alexjegers/RX7-Coolant-Temp-Controller-/Electrical/PCB Layout.JPG

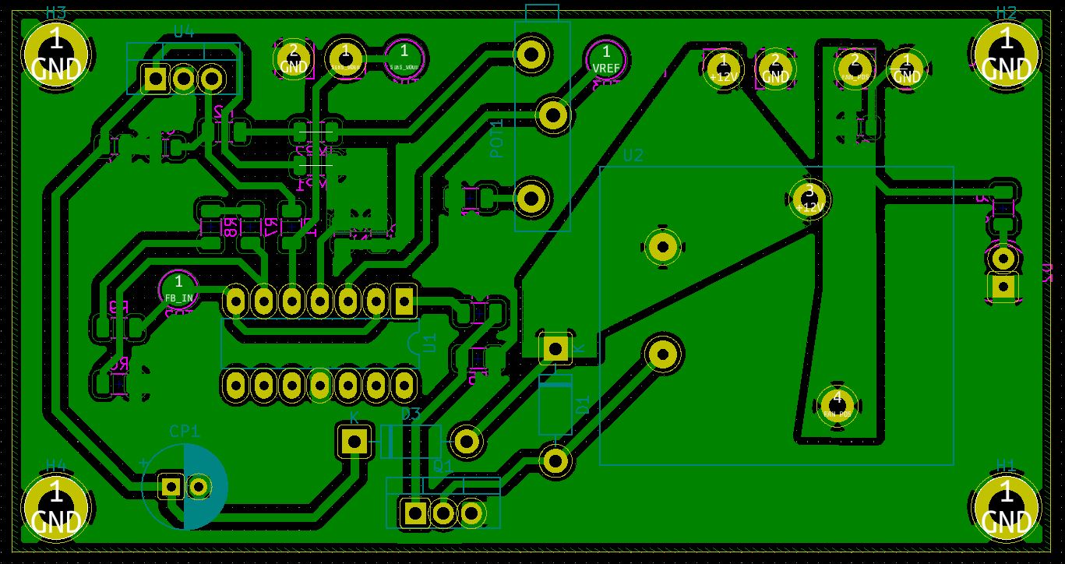
Electrical/PCB Layout.JPG
