alexjegers/RX7-Coolant-Temp-Controller-/Forum Posts/Comparator Circuit.PNG

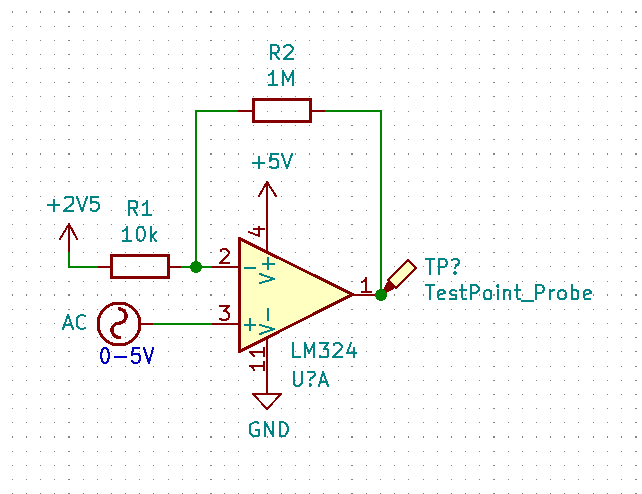
Forum Posts/Comparator Circuit.PNG
