alexjegers/RX7-Coolant-Temp-Controller-/Forum Posts/Reverse Polarity Circuit1.PNG

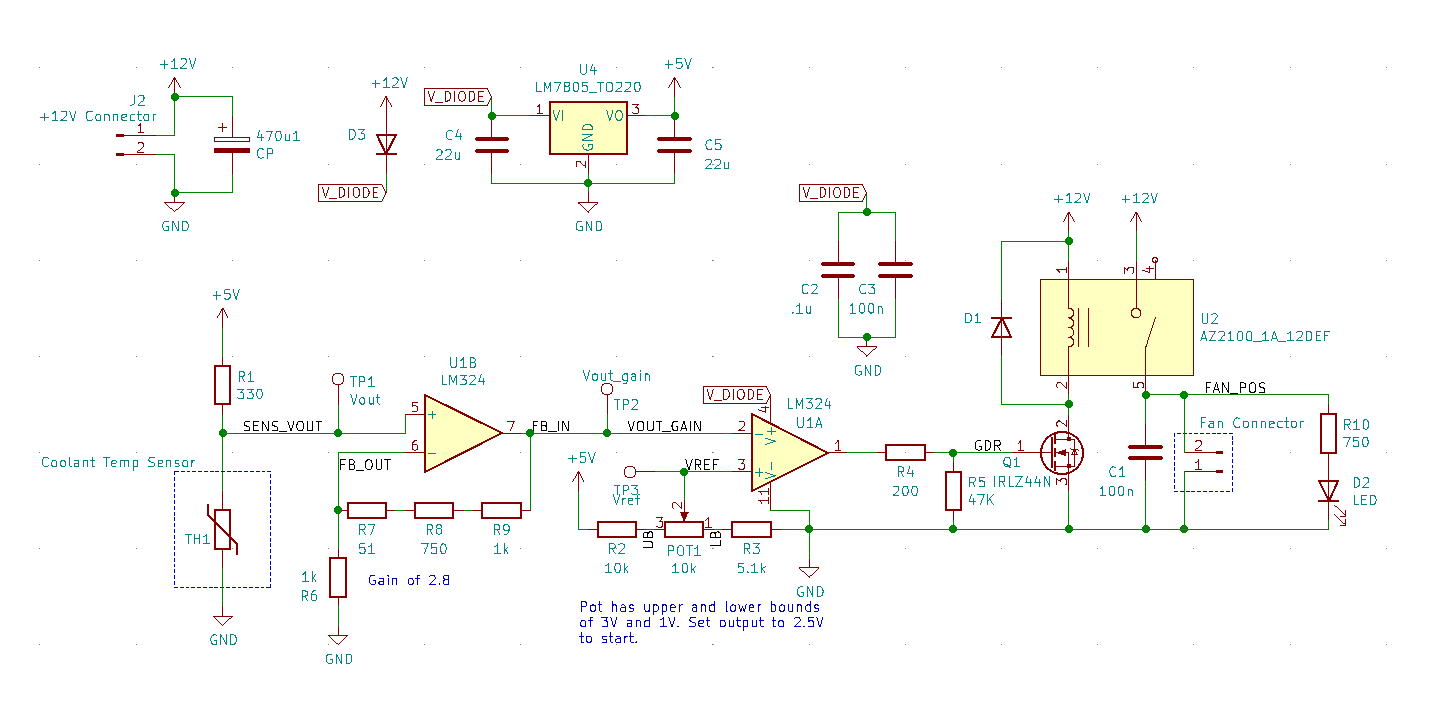
Forum Posts/Reverse Polarity Circuit1.PNG
