alexjegers/RX7-Coolant-Temp-Controller-/Forum Posts/Reverse Polarity Circuit2.PNG

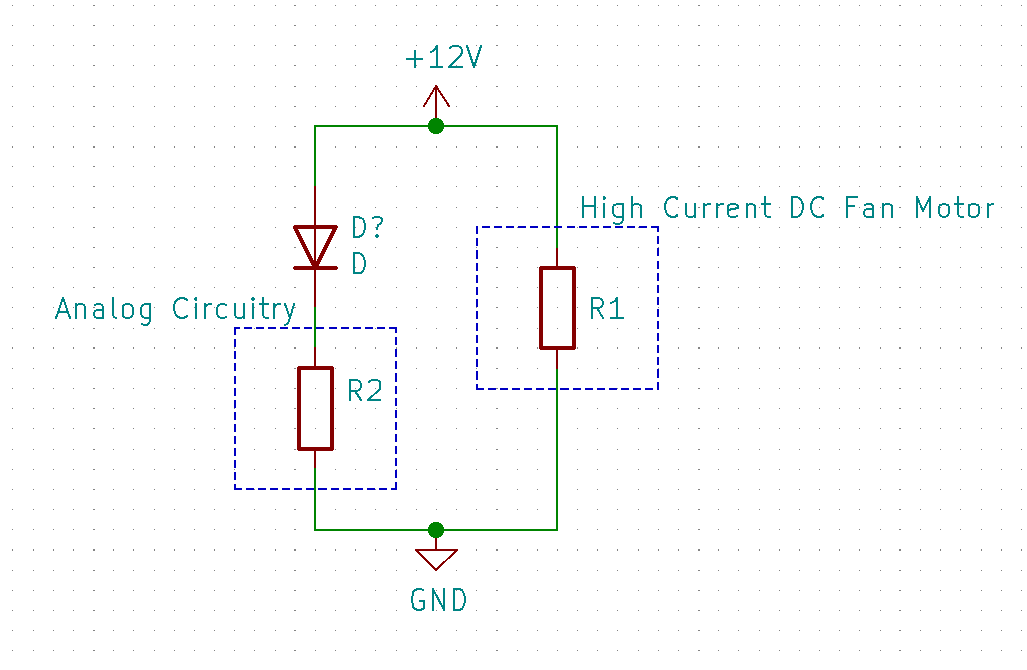
Forum Posts/Reverse Polarity Circuit2.PNG
