alexjegers/RX7-Coolant-Temp-Controller-/Forum Posts/Scope Capture.png

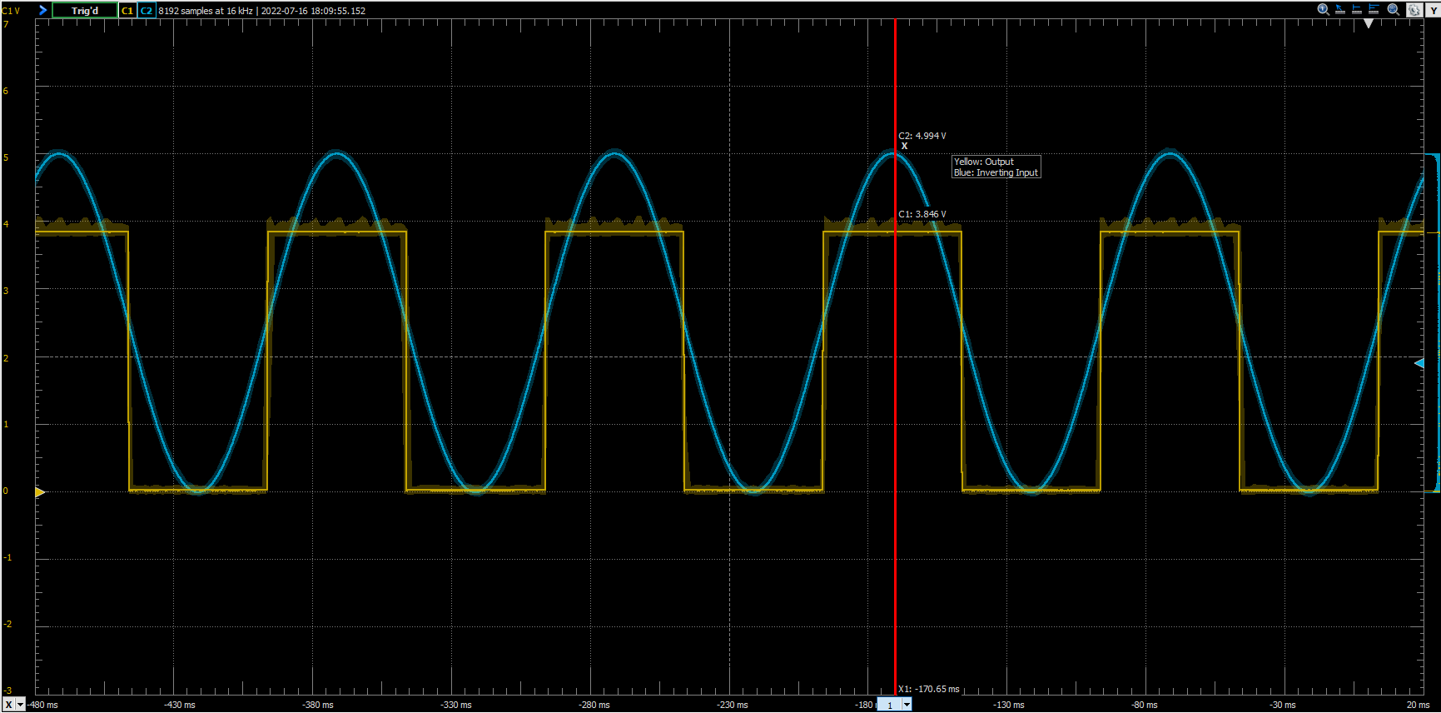
Forum Posts/Scope Capture.png
