alexjegers/RX7-Coolant-Temp-Controller-/CAD/RX7_COOLANT_TEMP_CONTROLLER_PCB_001.SLDASM

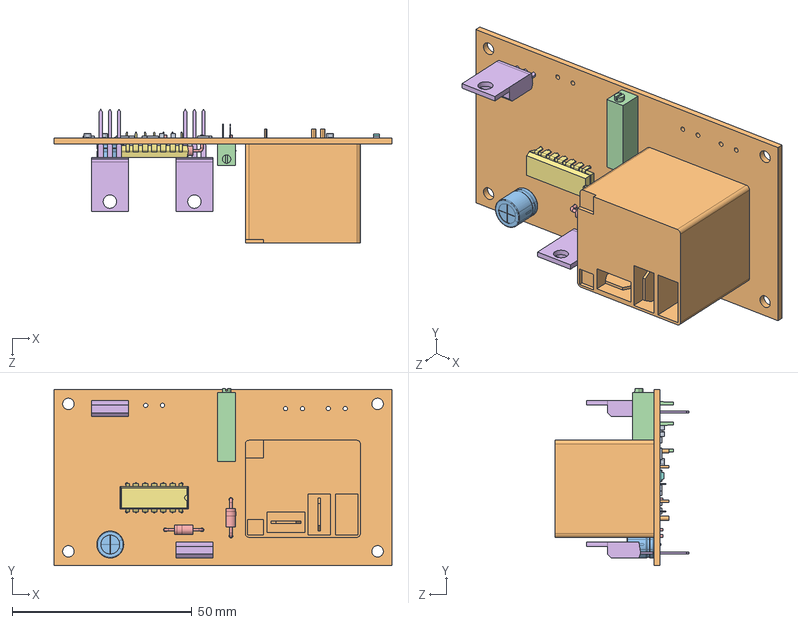
[picture p6: CAD file, 2022-11-08]
CAD/RX7_COOLANT_TEMP_CONTROLLER_PCB_001.SLDASM
94.0 x 49.4 x 37.2 mm
SOLID.step x 12
COMPOUND.step
SOLID-0.step
COMPOUND-1.step
SOLID-2.step x 2
SOLID-3.step x 2
SOLID-4.step
SOLID-5.step
SOLID-6.step x 5
COMPOUND-7.step
