alexjegers/RX7-Coolant-Temp-Controller-/CAD/FINAL_ASSEM_001.SLDASM

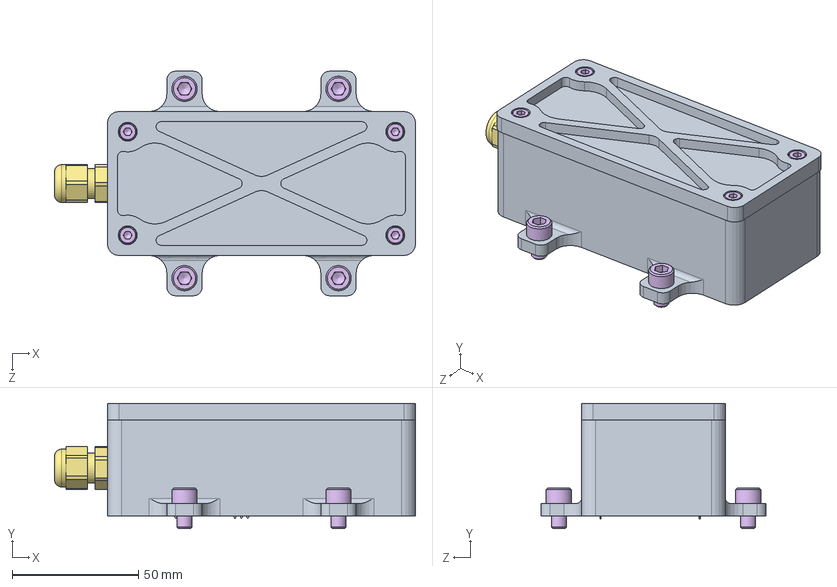
[picture p7: CAD file, 2022-11-08]
CAD/FINAL_ASSEM_001.SLDASM
143.0 x 49.6 x 89.0 mm
PCB_ENCLOSURE_001
SOLID.step x 12
COMPOUND.step
SOLID-0.step
COMPOUND-1.step
SOLID-2.step x 2
SOLID-3.step x 2
SOLID-4.step
SOLID-5.step
SOLID-6.step x 5
COMPOUND-7.step
M3_THREADED_INSERT x 4
M4_THREADED_INSERT x 4
socket head cap screw_am x 12
WIRE_STRAIN_RELIEF_SMALL_001
WIRE_STRAIN_RELIEF_SMALL_002
PCB_ENCLOSURE_LID_001
