alexjegers/RX7-Coolant-Temp-Controller-/CAD/WIRE_STRAIN_RELIEF_SMALL_001.SLDPRT

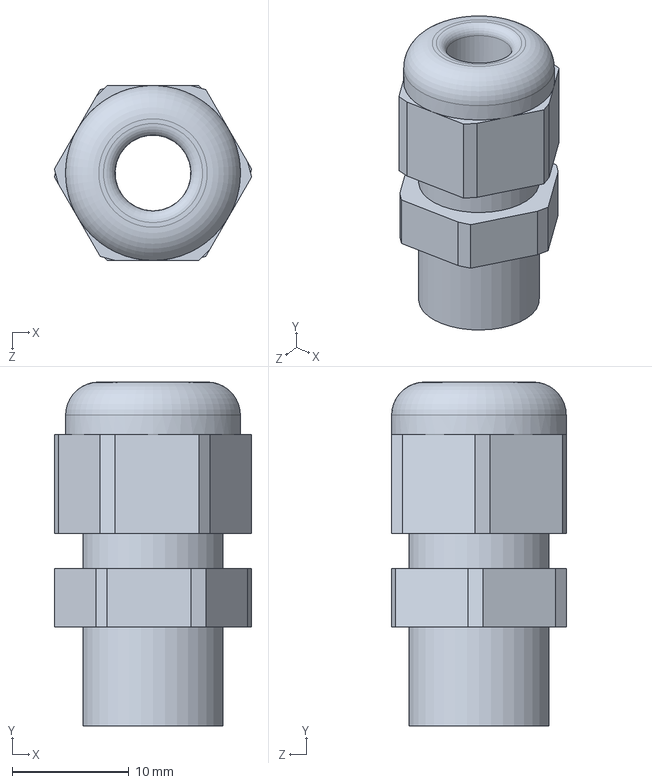
[picture p8: CAD file, 2022-11-08]
CAD/WIRE_STRAIN_RELIEF_SMALL_001.SLDPRT
16.9 x 29.5 x 15.0 mm
