alexjegers/RX7-Coolant-Temp-Controller-/CAD/PCB_ENCLOSURE_001.SLDPRT

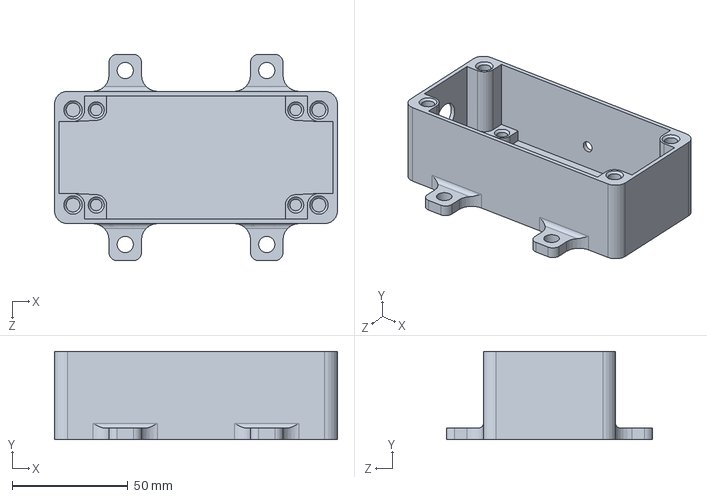
[picture p9: CAD file, 2022-11-08]
CAD/PCB_ENCLOSURE_001.SLDPRT
122.0 x 38.0 x 89.0 mm
