alexjegers/RX7-Coolant-Temp-Controller-/CAD/PCB_ENCLOSURE_LID_001.SLDPRT

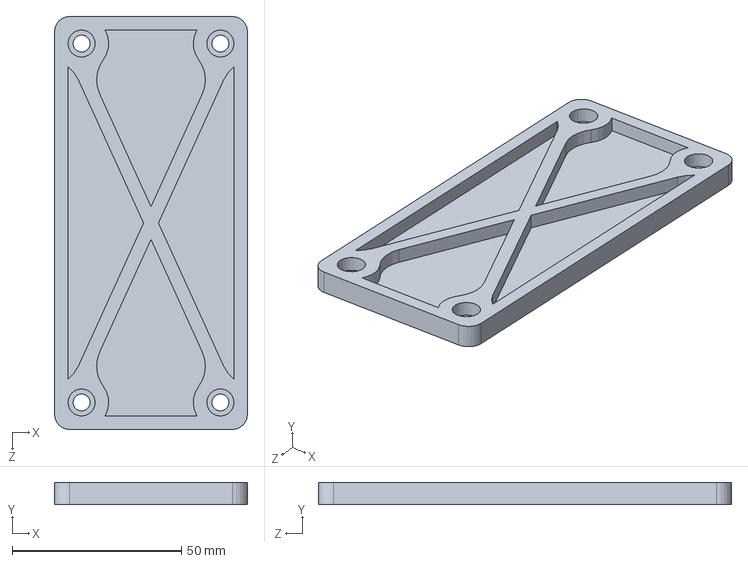
[picture p10: CAD file, 2022-11-08]
CAD/PCB_ENCLOSURE_LID_001.SLDPRT
57.0 x 6.60 x 122.0 mm
