alexjegers/RX7-Coolant-Temp-Controller-/CAD/M3_THREADED_INSERT.SLDPRT

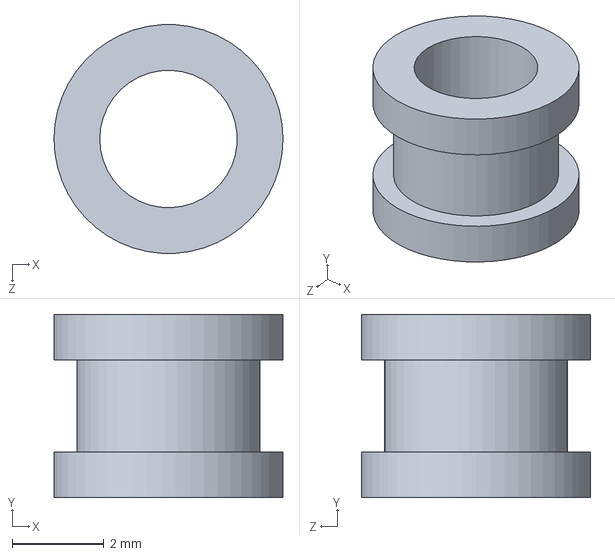
[picture p11: CAD file, 2022-11-08]
CAD/M3_THREADED_INSERT.SLDPRT
5.00 x 4.00 x 4.99 mm
