alexjegers/RX7-Coolant-Temp-Controller-/CAD/WIRE_STRAIN_RELIEF_SMALL_002.SLDPRT

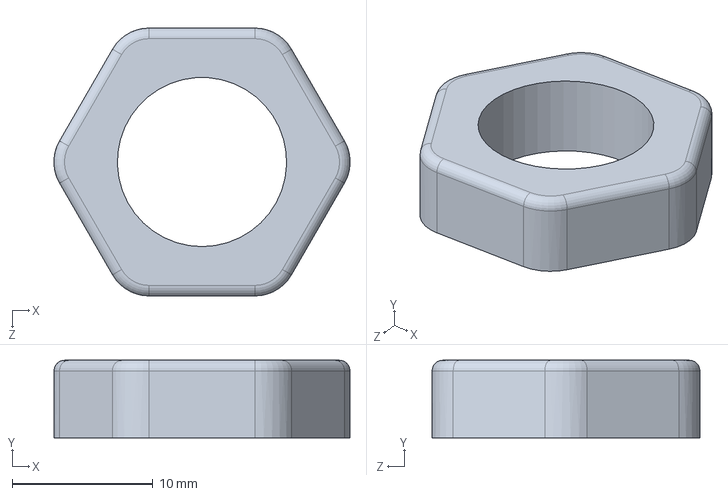
[picture p12: CAD file, 2022-11-08]
CAD/WIRE_STRAIN_RELIEF_SMALL_002.SLDPRT
21.0 x 5.50 x 19.0 mm
