alexjegers/RX7-Coolant-Temp-Controller-/CAD/POTENTIOMETER_3D_001.STEP

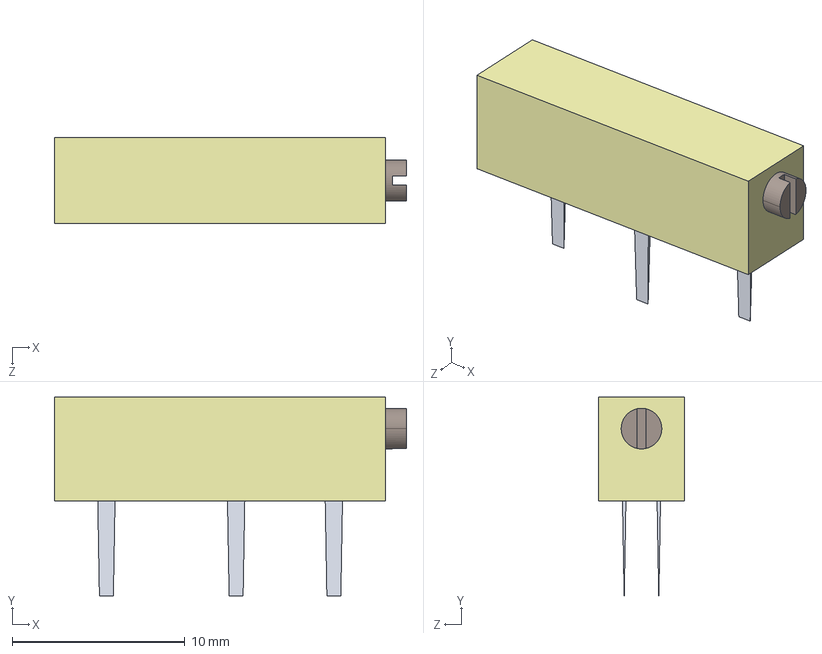
[picture p13: CAD file, 2022-11-08]
CAD/POTENTIOMETER_3D_001.STEP
20.3 x 11.5 x 5.00 mm
