alexjegers/RX7-Coolant-Temp-Controller-/CAD/RELAY_3D_001.STEP

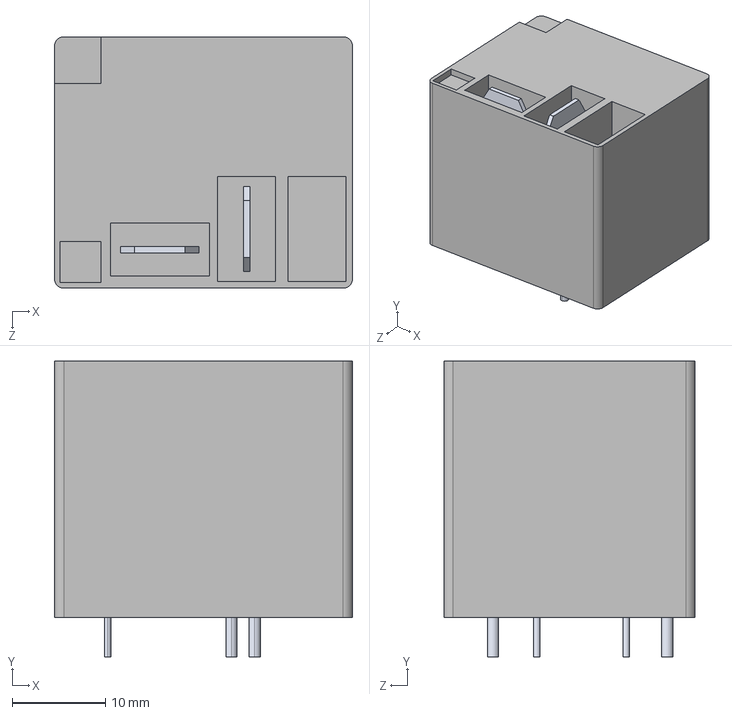
[picture p14: CAD file, 2022-11-08]
CAD/RELAY_3D_001.STEP
32.0 x 31.8 x 27.0 mm
