alexjegers/RX7-Coolant-Temp-Controller-/CAD/M4_THREADED_INSERT.SLDPRT

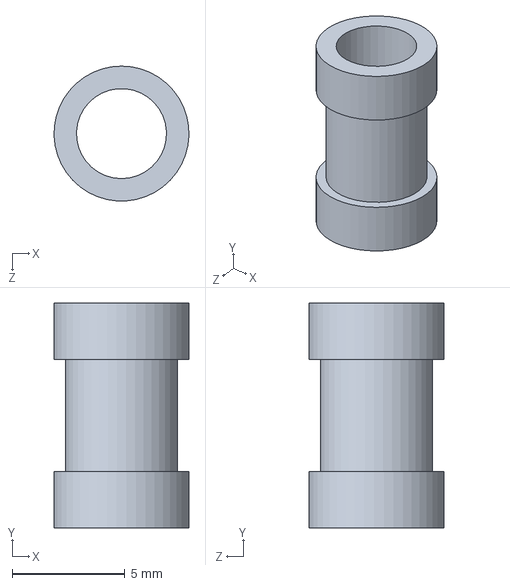
[picture p15: CAD file, 2022-11-08]
CAD/M4_THREADED_INSERT.SLDPRT
6.00 x 10.0 x 5.99 mm
