alexjegers/RX7-Coolant-Temp-Controller-/(list of files, cad)

Other CAD files:
CAD/RX7_COOLANT_TEMP_CONTROLLER.step
CAD/STL_PCB_ENCLOSURE_001.STL
CAD/PCB_ENCLOSURE_LID_001.STL
CAD/POTENTIOMETER_3D_001.SLDPRT
CAD/RELAY_3D_001.SLDPRT
