alexjegers/RX7-Coolant-Temp-Controller-/Electrical/RX7_COOLANT_TEMP_CONTROLLER.pdf

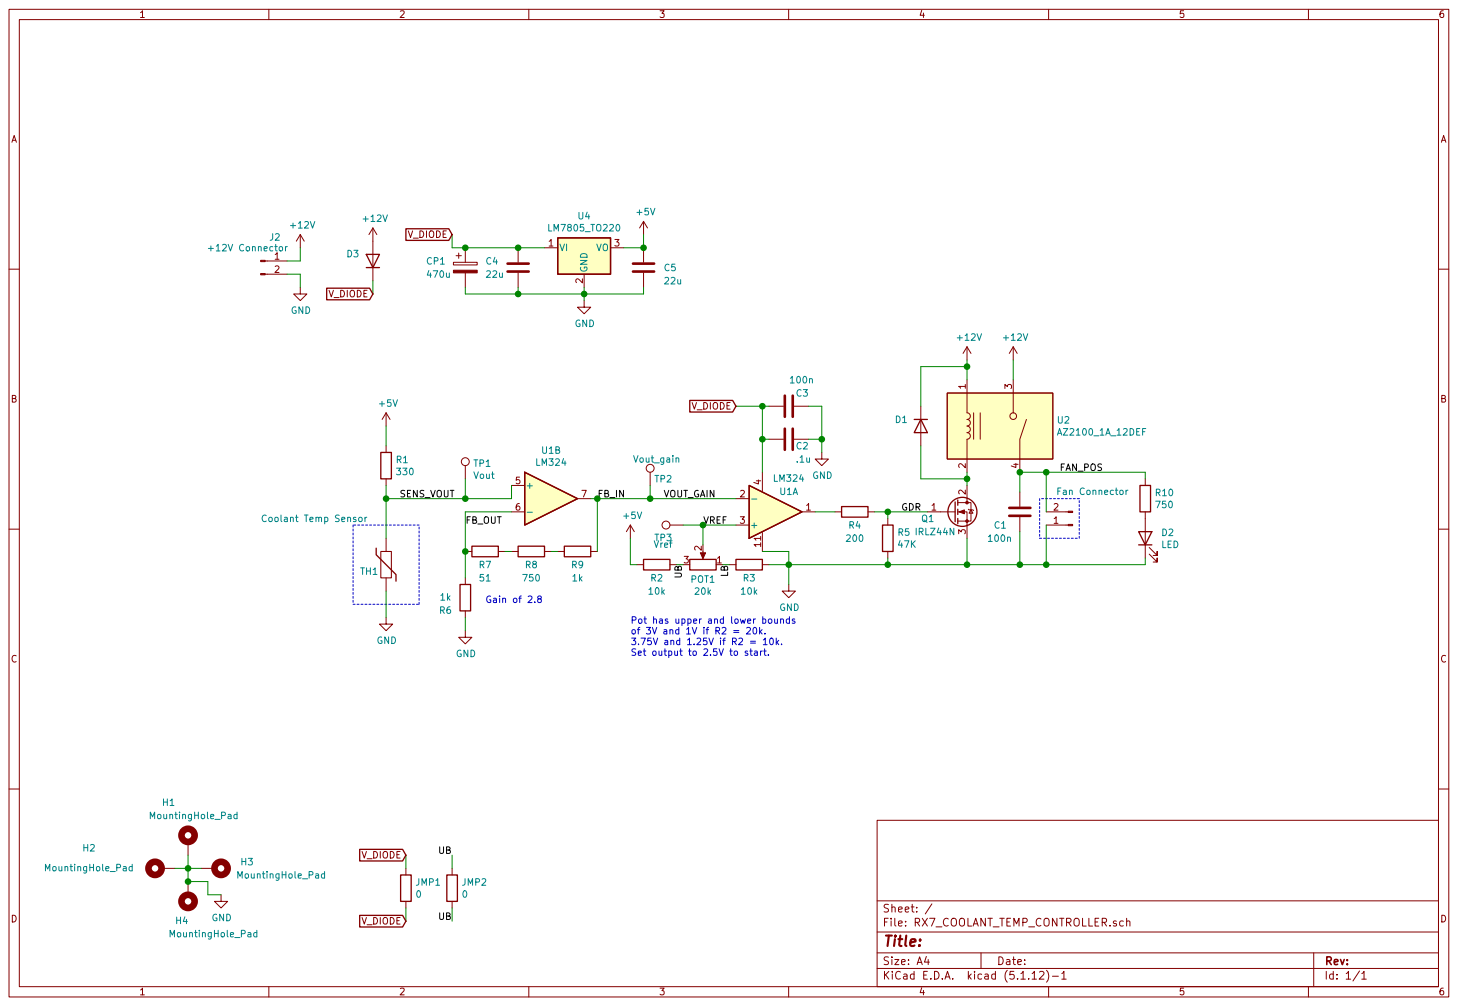
[picture p16: page 1]
