alexjegers/RX7-Coolant-Temp-Controller-/Electrical/RX7_COOLANT_TEMP_CONTROLLER.kicad_pcb

## KiCad design Electrical/RX7_COOLANT_TEMP_CONTROLLER.kicad_pcb (2022-11-08)

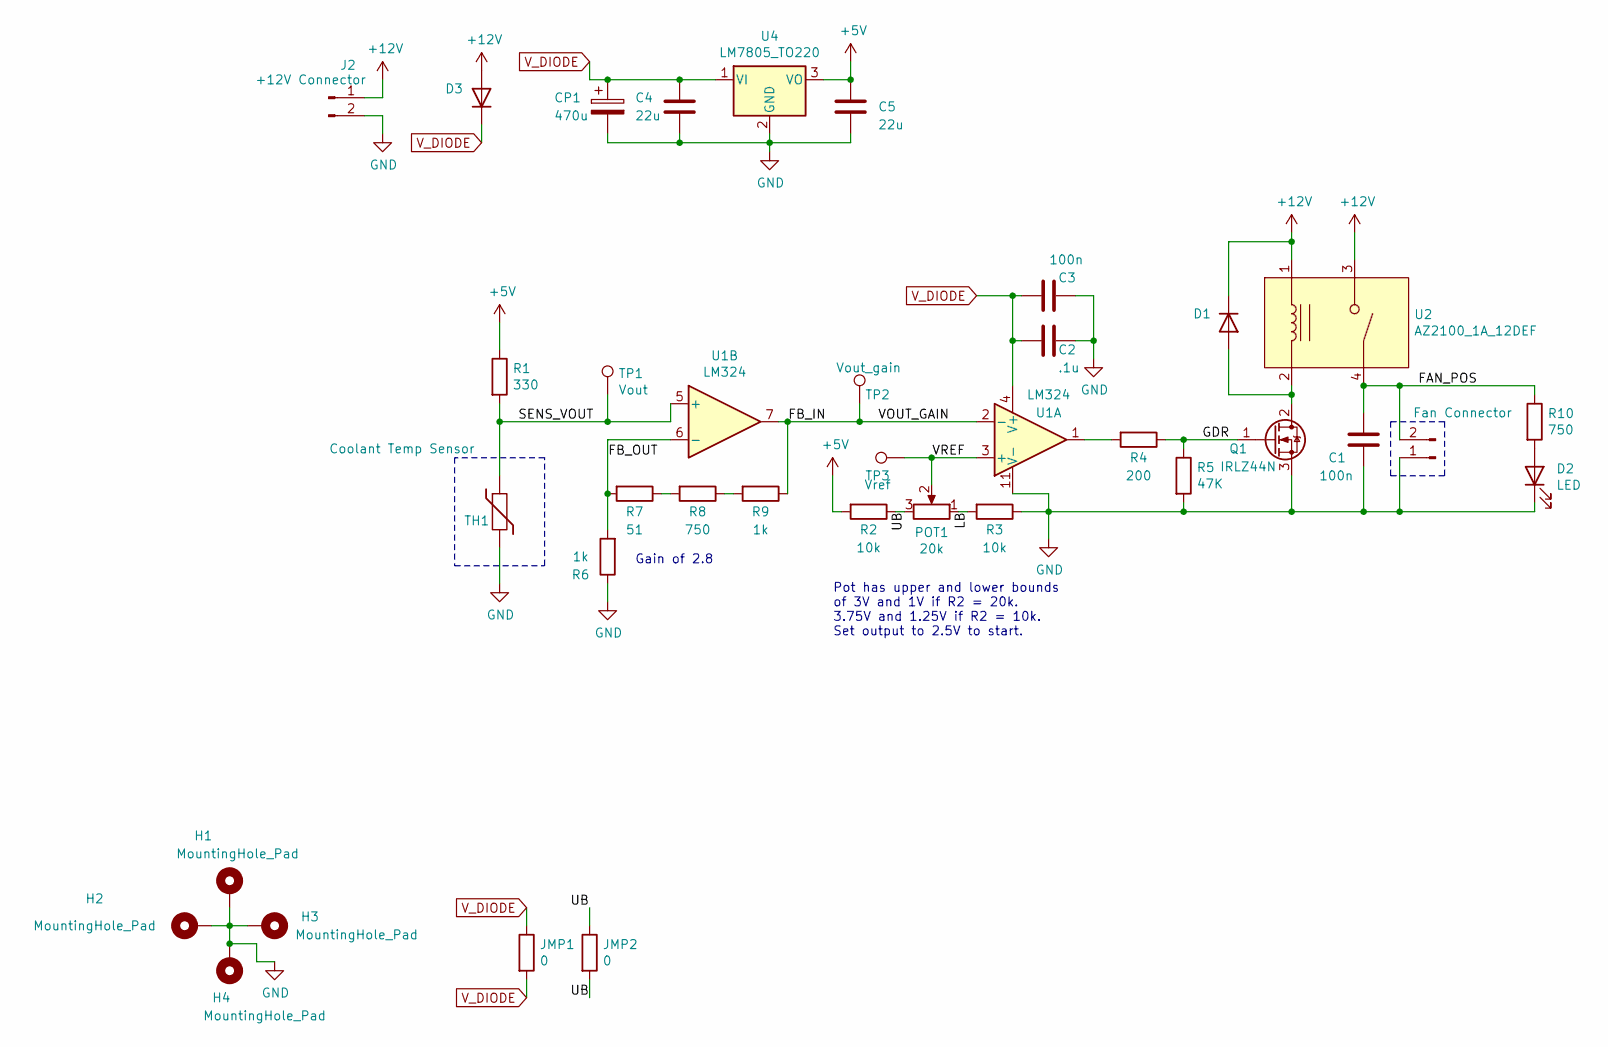
[picture p17: schematic RX7_COOLANT_TEMP_CONTROLLER.sch]

Parts:
C1, C3: 100n; C_0805_2012Metric
C2: .1u; C_0805_2012Metric
C4, C5: 22u; C_0805_2012Metric
CP1: 470u; CP_Radial_D7.5mm_P2.50mm
D1, D3: 1N1589; D_DO-41_SOD81_P10.16mm_Horizontal
D2: LED; LED_D5.0mm
H1, H2, H3, H4: MountingHole_Pad; MountingHole_3.2mm_M3_DIN965_Pad
J1: Fan Connector; RX-7_COOLANT_TEMP_2_PIN_CONN
J2: +12V Connector; RX-7_COOLANT_TEMP_2_PIN_CONN
JMP1, JMP2: 0; R_1206_3216Metric
POT1: 20k; 20K_RECT_POT
Q1: IRLZ44N; TO-220-3_Vertical
R1: 330; R_1206_3216Metric
R2, R3: 10k; R_1206_3216Metric
R4: 200; R_1206_3216Metric
R5: 47K; R_1206_3216Metric
R6, R9: 1k; R_1206_3216Metric
R7: 51; R_1206_3216Metric
R8, R10: 750; R_1206_3216Metric
TH1: Coolant Temp Sensor; RX-7_COOLANT_TEMP_2_PIN_CONN
TP1: Vout; TestPoint_Pad_D3.0mm
TP2: Vout_gain; TestPoint_Pad_D3.0mm
TP3: Vref; TestPoint_Pad_D3.0mm
U1: LM324; DIP-14_W7.62mm_LongPads
U2: AZ2100_1A_12DEF
U4: LM7805_TO220; TO-220-3_Vertical

Connections:
+5V: C5.1, R1.1, R2.2, U4.3 (VO)
+12V: D1.1 (K), D3.2 (A), J2.1, U2.1, U2.3
/FAN_POS: C1.1, J1.2, R10.1, U2.4
/FB_IN: R9.1, TP2.1, U1.2 (-), U1.7
/FB_OUT: R6.2, R7.2, U1.6 (-)
/GDR: Q1.1 (G), R4.1, R5.1
/LB: POT1.1, R3.2
/SENS_VOUT: R1.2, TH1.1, TP1.1, U1.5 (+)
/UB: JMP2.1, JMP2.2, POT1.3, R2.1
/VREF: POT1.2, TP3.1, U1.3 (+)
GND: C1.2, C2.1, C3.1, C4.2, C5.2, CP1.2, D2.1 (K), H1.1, H2.1, H3.1, H4.1, J1.1, J2.2, Q1.3 (S), R3.1, R5.2, R6.1, TH1.2, U1.11 (V-), U4.2 (GND)
unnamed: D1.2 (A), Q1.2 (D), U2.2
unnamed: D2.2 (A), R10.2
unnamed: R4.2, U1.1
unnamed: R7.1, R8.2
unnamed: R8.1, R9.2
V_DIODE: C2.2, C3.2, C4.1, CP1.1, D3.1 (K), JMP1.1, JMP1.2, U1.4 (V+), U4.1 (VI)

Notes on the sheet:
Gain of 2.8
Pot has upper and lower bounds of 3V and 1V if R2 = 20k. 3.75V and 1.25V if R2 = 10k. Set output to 2.5V to start.

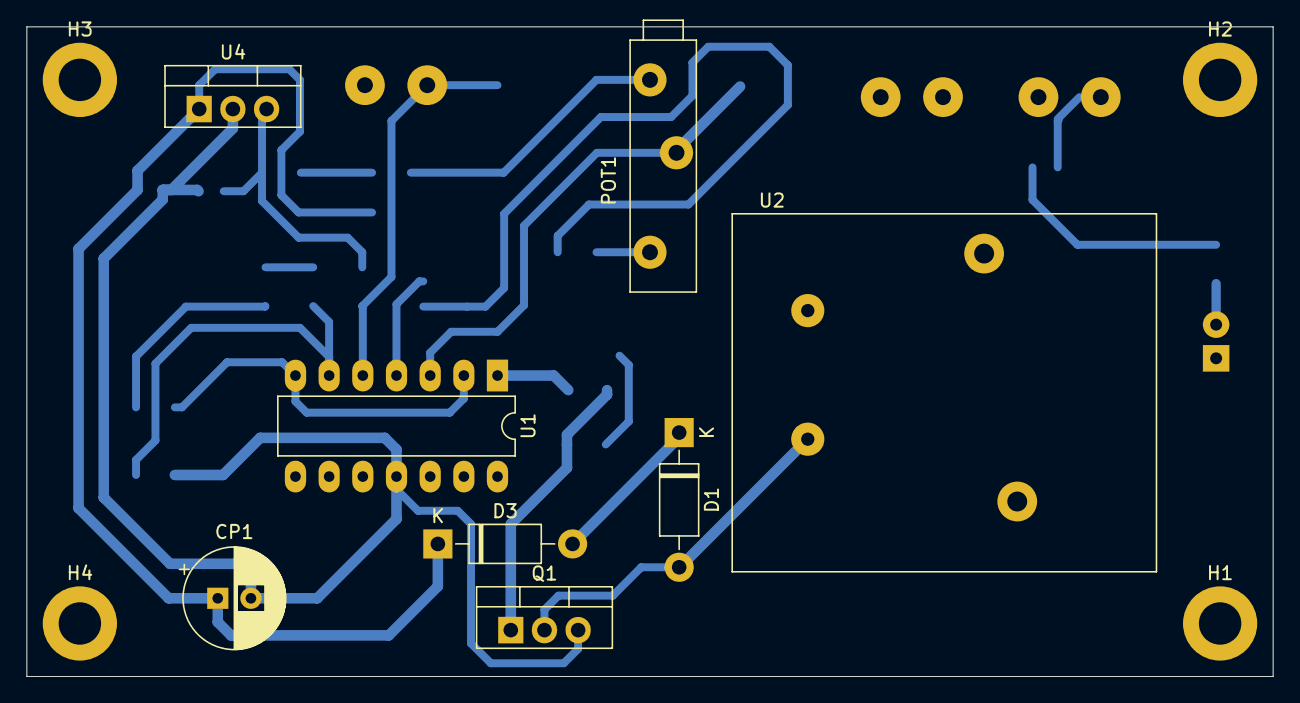
[picture p18: board RX7_COOLANT_TEMP_CONTROLLER.kicad_pcb from above]

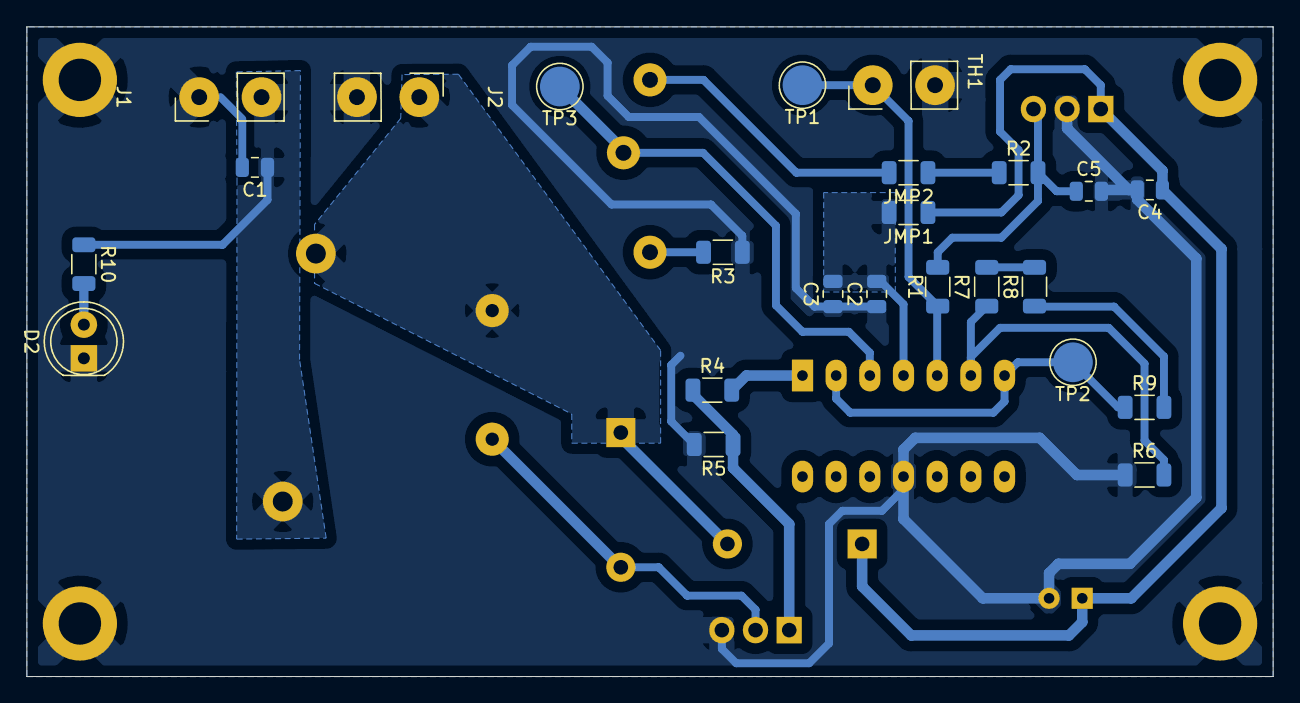
[picture p19: board RX7_COOLANT_TEMP_CONTROLLER.kicad_pcb from below]

Board: 2 copper layers, 94.0 x 49.0 mm, 36 parts (24 on the bottom side), 17 nets.
